szadil763/gabinete-cooktop-itatiaia/docs/images/preview_conectores.png

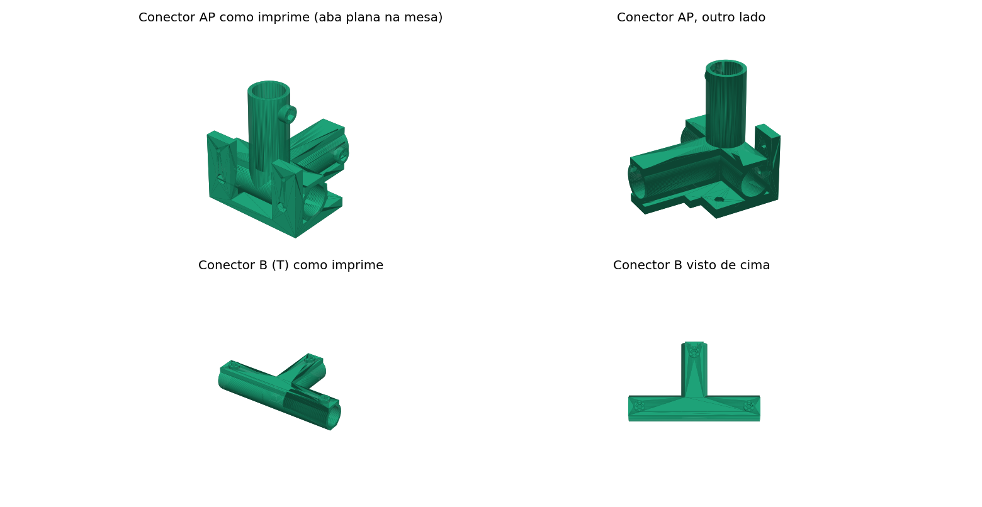
docs/images/preview_conectores.png
