szadil763/gabinete-cooktop-itatiaia/dxf/portas_acrilico.dxf

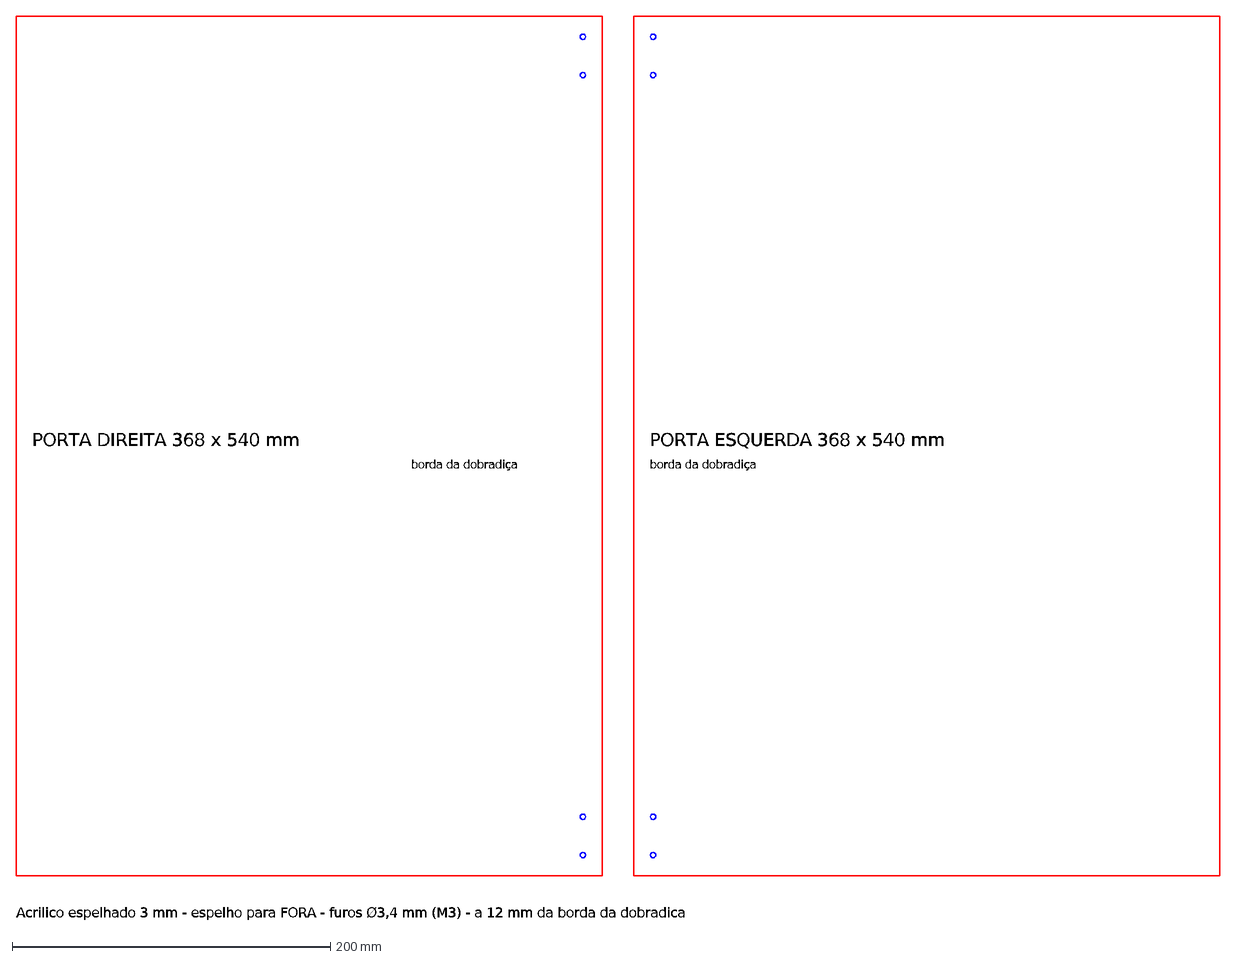
[picture p2: CAD file, 2026-10-14]
dxf/portas_acrilico.dxf
PORTA DIREITA 368 x 540 mm
borda da dobradiça
PORTA ESQUERDA 368 x 540 mm
Acrilico espelhado 3 mm - espelho para FORA - furos Ø3,4 mm (M3) - a 12 mm da borda da dobradica
