szadil763/gabinete-cooktop-itatiaia/stl/calibracao_xy.stl

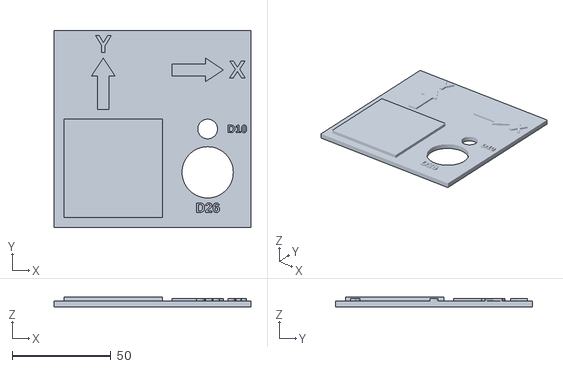
[picture p3: CAD file, 2026-10-27]
stl/calibracao_xy.stl
100.0 x 100.0 x 5.00
