szadil763/gabinete-cooktop-itatiaia/stl/dobradica_suporte.stl

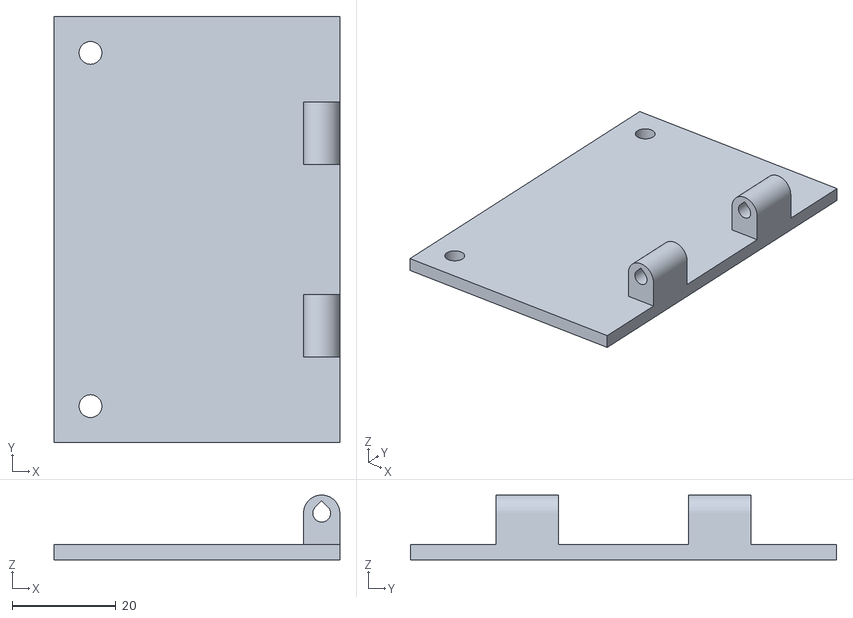
[picture p4: CAD file, 2026-10-14]
stl/dobradica_suporte.stl
55.0 x 82.0 x 12.5
