szadil763/gabinete-cooktop-itatiaia/stl/conector_B.stl

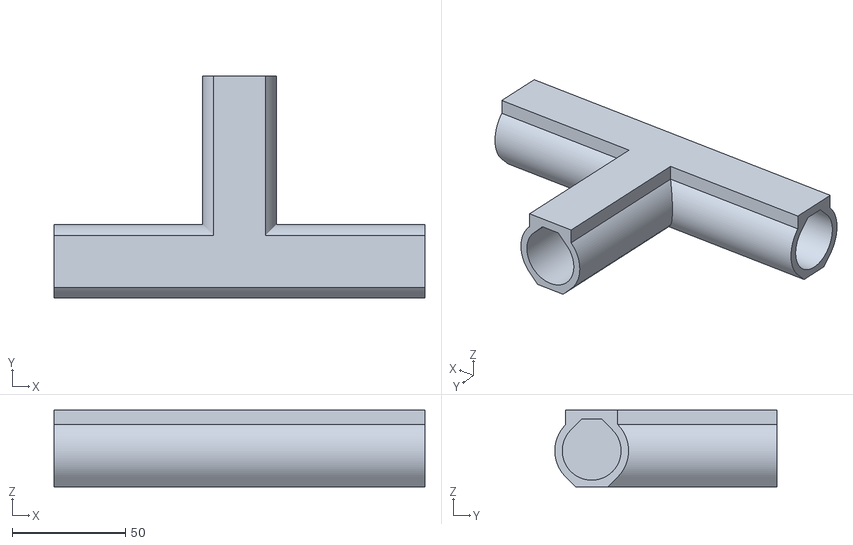
[picture p5: CAD file, 2026-10-14]
stl/conector_B.stl
164.0 x 98.3 x 34.0
