szadil763/gabinete-cooktop-itatiaia/stl/teste_folga.stl

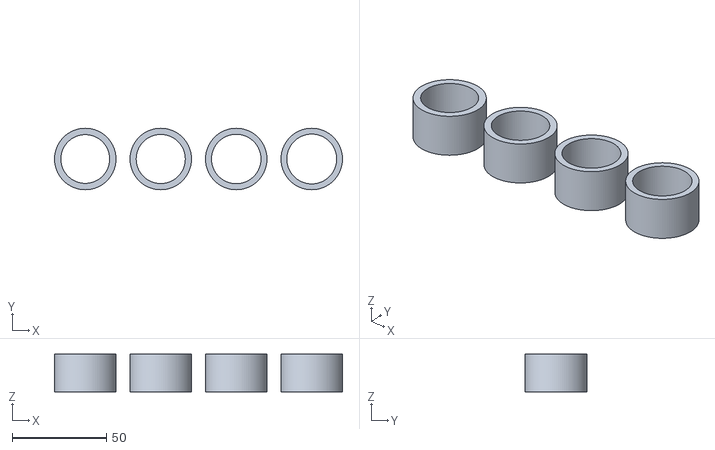
[picture p6: CAD file, 2026-10-14]
stl/teste_folga.stl
152.6 x 32.6 x 20.0
