szadil763/gabinete-cooktop-itatiaia/stl/conector_AP.stl

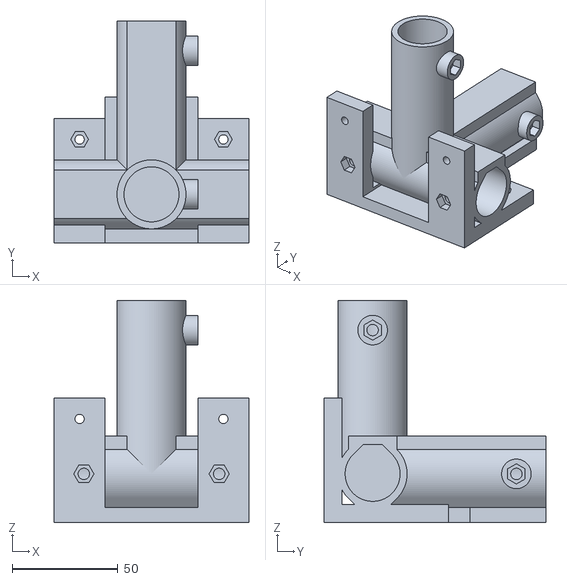
[picture p7: CAD file, 2026-10-14]
stl/conector_AP.stl
92.0 x 105.0 x 105.0
