szadil763/gabinete-cooktop-itatiaia/stl/dobradica_porta.stl

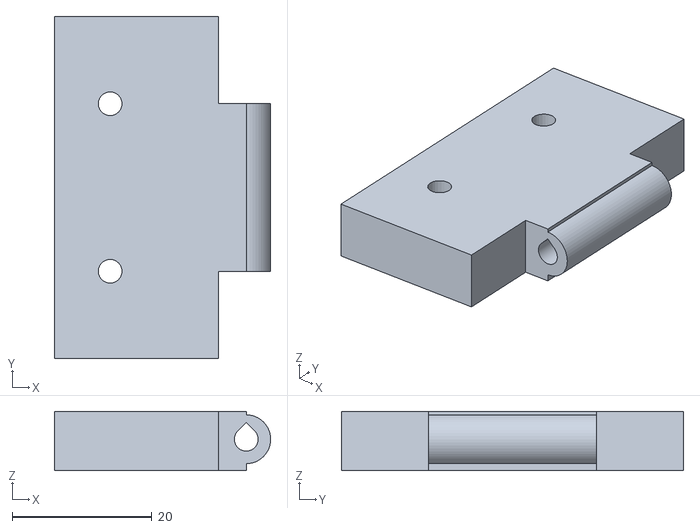
[picture p8: CAD file, 2026-10-14]
stl/dobradica_porta.stl
31.0 x 49.0 x 8.50
