szadil763/gabinete-cooktop-itatiaia/(list of files, cad)

Other CAD files:
dxf/mdf_pecas.dxf
