szadil763/gabinete-cooktop-itatiaia/simulacoes/simulacao_montagem_3d.html

# Gabinete do cooktop · simulação de montagem 3D

Tubo Ø25,6 mm · conectores impressos em PETG · MDF 15 mm com plástico branco de 0,5 mm nas duas faces, portas de acrílico espelhado com dobradiças presas aos conectores. Sequência validada por colisão nos arquivos STL reais.

peças do passoplásticodobradiçasmontagem final

arraste para girar · roda ou pinça para zoom

⏮ ◀ Anterior ▶ Reproduzir Próximo ▶ ⏭

Passo

Movimento

Velocidade Reflexo do espelho Câmera automática Plástico branco 0,5 mm Montagem final (fantasma) Avançar sozinho
