szadil763/gabinete-cooktop-itatiaia/(commit log)

2026-10-14 Estrutura inicial do projeto: conectores, dobradiça, DXFs, plano de montagem e simulações 3D
    Claude-Session: https://claude.ai/code/session_014qqL72Ajz28PCqJWKtTDtz
    [conector_AP.stl, conector_B.stl, conectores_gabinete.scad, dobradica_porta.stl, dobradica_suporte.stl, mdf_pecas.dxf, portas_acrilico.dxf, teste_folga.stl]
2026-10-27 Adiciona peça de teste de calibração XY (quadrado 50x50 + furos D26/D10) para diagnosticar ovalização/erro de escala por eixo
    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
    [calibracao_xy.scad, calibracao_xy.stl]
2026-10-27 Adiciona perfil de impressão ajustado para PETG preto (lote/marca diferente)
    Baseado no perfil antiEntupimento, com reforço só na primeira camada
    (mesa +5°C, velocidade -20%, fluxo +4%, largura +3%) para compensar a
    diferença de aderência entre o PETG dourado anterior e o novo lote
    preto, sem alterar os parâmetros do resto da impressão.
    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
